ZacharyCarey/Dot-Matrix-Printer-Web-Interface/hardware/Board design 2025-09-17.png

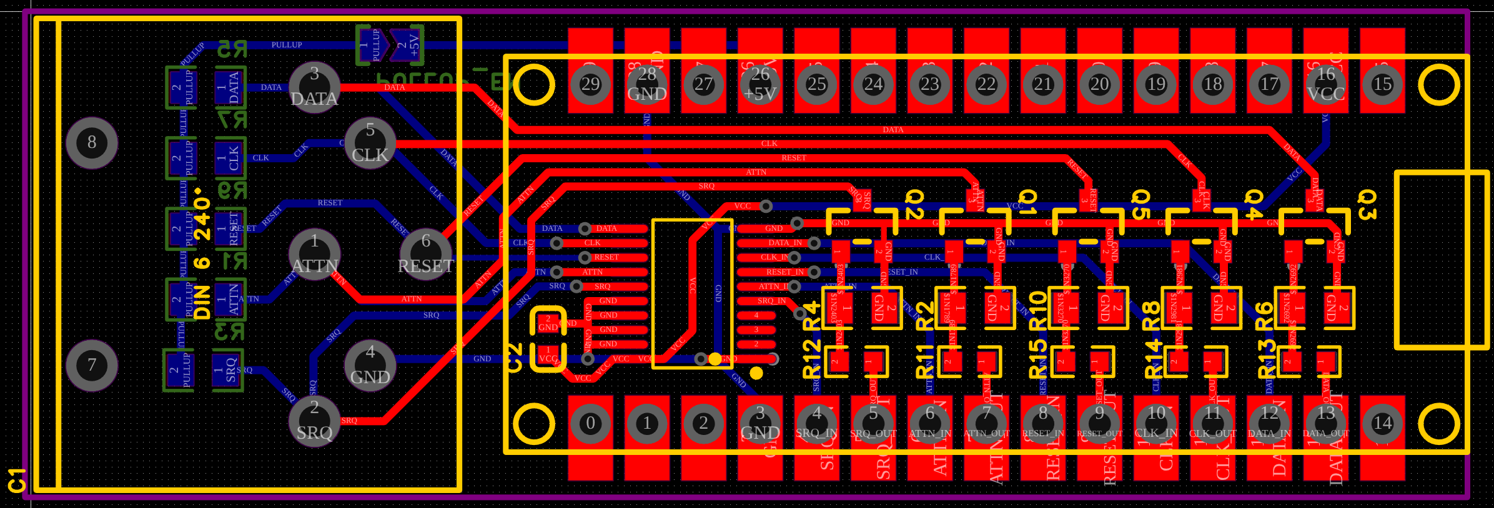
hardware/Board design 2025-09-17.png
