ZacharyCarey/Dot-Matrix-Printer-Web-Interface/hardware/Schematic design 2025-09-17.png

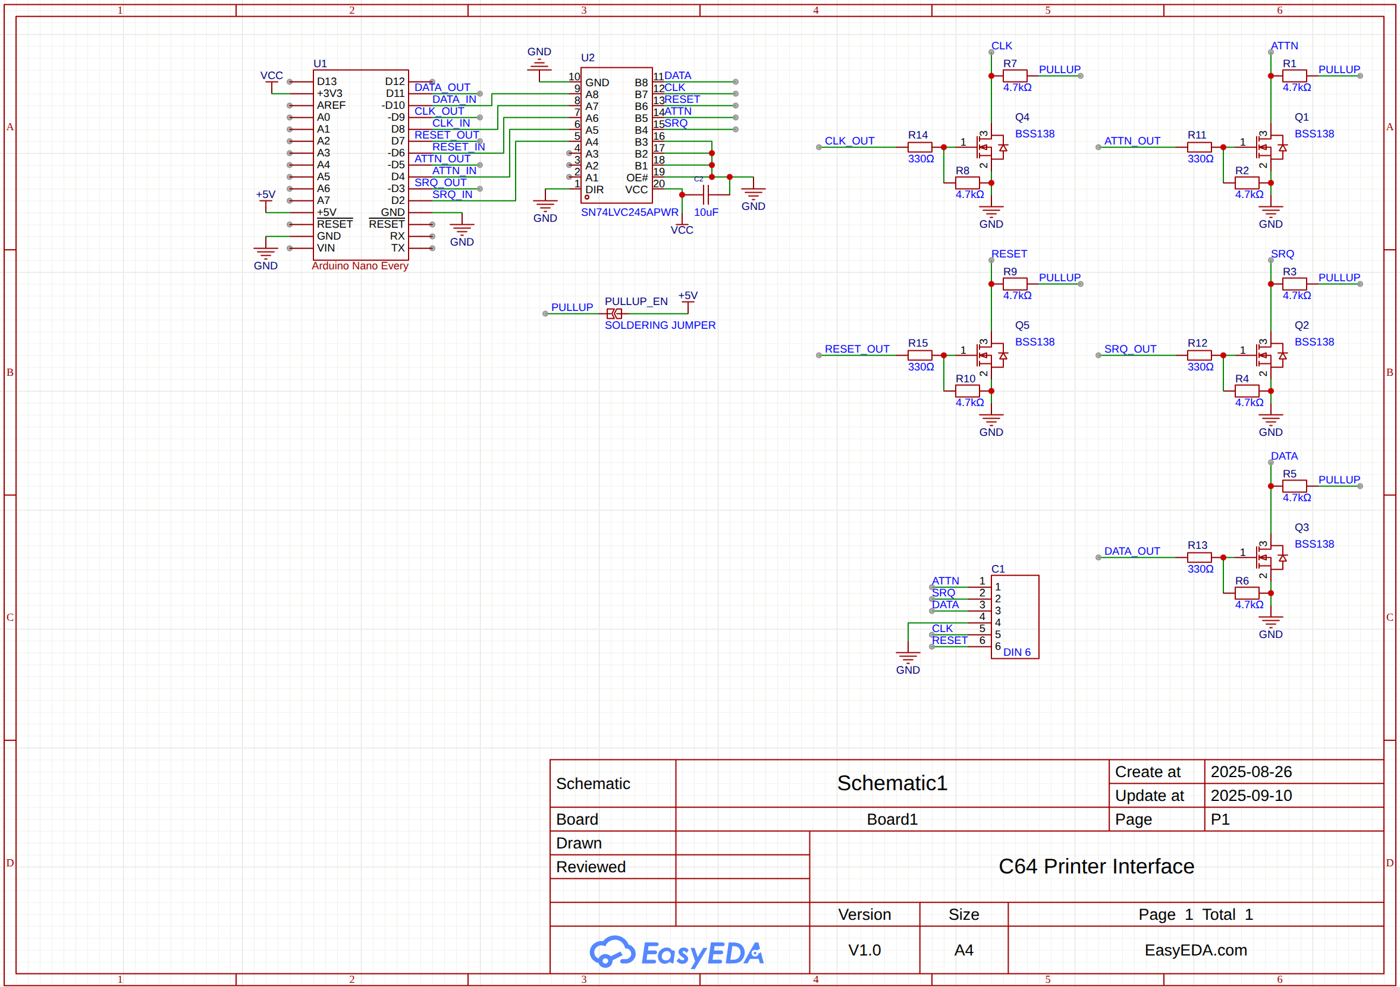
hardware/Schematic design 2025-09-17.png
