ZacharyCarey/Dot-Matrix-Printer-Web-Interface/hardware/BOM_Board1_PCB1_2025-08-30.csv

No. | Quantity | Comment | Designator | Footprint | Manufacturer PN | Digikey PN | JLCPCB PN
1 | 1 | DIN 6 Connector | C1 | FC680806 | FC680806 | 4654-FC680806-ND
2 | 5 | MOSFET | Q | SOT-23-3 | BSS138 | BSS138CT-ND | C2938375
3 | 10 | 4.7kΩ |  | 0805 | R1-R10 |  | C336873
4 | 1 | 10uF |  | 0603 | C2 |  | C96446
5 | 5 | 330Ω |  | 0603 | R11-R15 |  | C23138
6 | 1 | Voltage shifter | SN74LVC245A | TSSOP-20 | SN74LVC245APWR |  | C7848
7 | 1 | Arduino Nano ESP32 | U1 | Arduino Nano
