ZacharyCarey/Dot-Matrix-Printer-Web-Interface/hardware/JLCPCB_BOM.csv

No. | Quantity | Comment | Designator | Footprint | Value | Manufacturer Part | Manufacturer | Supplier Part | Supplier
1 | 1 | DIN 6 | C1 | FC680806
2 | 1 | 10uF | C2 | C0603 | 10uF | CL10A106MA8NRNC | SAMSUNG(三星) | C96446 | LCSC
3 | 1 | SOLDERING JUMPER | PULLUP_EN | JUMPER |  | SOLDERING JUMPER
4 | 5 | BSS138 | Q1,Q2,Q3,Q4,Q5 | SOT-23_L2.9-W1.3-P1.90-LS2.4-BR |  | BSS138 | GOODWORK(固得沃克) | C2938375 | LCSC
5 | 10 | 4.7kΩ | R1,R2,R3,R4,R5,R6,R7,R8,R9,R10 | R0805 | 4.7kΩ | ERJ6RBD4701V | PANASONIC(松下) | C336873 | LCSC
6 | 5 | 330Ω | R11,R12,R13,R14,R15 | R0603 | 330Ω | 0603WAF3300T5E | UNI-ROYAL(厚声) | C23138 | LCSC
7 | 1 | Arduino Nano Every | U1 | Arduino Nano Every (SMD)
8 | 1 | SN74LVC245APWR | U2 | TSSOP-20_L6.5-W4.4-P0.65-LS6.4-BL |  | SN74LVC245APWR | TI(德州仪器) | C7848 | LCSC
