ZacharyCarey/Dot-Matrix-Printer-Web-Interface/(list of files, drawings)

Other design files:
hardware/ProPrj_C64 Printer Interface_2025-09-17.epro
