ZacharyCarey/Dot-Matrix-Printer-Web-Interface/Dot-Matrix-Printer-Web-Interface/okidata120.cpp

#include "okidata120.h"

// TODO 178 = squared, 179 = cubed

uint8_t CURSOR_UP_LOOKUP[256] = {
  0, // NUL
  0, // 1
  0, // 2
  0, // 3
  0, // 4
  0, // 5
  0, // 6
  0, // 7
  0, // Backspace 8
  0, // Horizontal tab 9
  13, // Line feed \n 10
  0, // 11
  0, // Form feed 12
  0, // Carriage return \r 13
  0, // 14
  0, // 15
  0, // 16
  0, // 17
  0, // 18
  0, // 19
  0, // 20
  0, // 21
  0, // 22
  0, // 23
  0, // 24
  0, // 25
  0, // 26
  0, // Escape
  0, // 28
  0, // 29
  0, // 30
  0, // 31
  32, // Space
  33, // ! 33
  34, // " 34
  35, // # 35
  36, // $ 36
  37, // % 37
  38, // & 38
  39, // ' 39
  40, // ( 40
  41, // ) 41
  42, // * 42
  43, // + 43
  44, // , 44
  45, // - 45
  46, // . 46
  47, // / 47
  48, // 0 48
  49, // 1 49
  50, // 2 50
  51, // 3 51
  52, // 4 52
  53, // 5 53
  54, // 6 54
  55, // 7 55
  56, // 8 56
  57, // 9 57
  58, // : 58
  59, // ; 59
  60, // < 60
  61, // = 61
  62, // > 62
  63, // ? 63
  64, // @ 64
  65, // A 65
  66, // B 66
  67, // C 67
  68, // D 68
  69, // E 69
  70, // F 70
  71, // G 71
  72, // H 72
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
  0, // DEL 127
  92, // Euro => British pound 128
  0, // 129
  0, // 130
  0, // 131
  0, // 132
  0, // 133
  0, // 134
  0, // 135
  0, // 136
  0, // 137
  0, // 138
  0, // 139
  0, // 140
  0, // 141
  0, // 142
  0, // 143
  0, // 144
  39, // left single quote => ' 145
  39, // right single quote => ' 146
  34, // left double quote => " 147
  34, // right double quote => " 148
  113, // Bullet 149
  45, // en dash 150
  45, // em dash 151
  0, // 152
  0, // 153
  0, // 154
  0, // 155
  0, // 156
  0, // 157
  0, // 158
  0, // 159
  0, // 160
  0, // 161
  0, // 162
  92, // British pound 163
  0, // 164
  0, // 165
  0, // 166
  0, // 167
  0, // 168
  0, // 169
  0, // 170
  0, // 171
  0, // 172
  0, // 173
  0, // 174
  0, // 175
  0, // 176
  0, // 177
  0, // 178
  0, // 179
  0, // 180
  0, // 181
  0, // 182
  0, // 183
  0, // 184
  0, // 185
  0, // 186
  0, // 187
  0, // 188
  0, // 189
  0, // 190
  0, // 191
  0, // 192
  0, // 193
  0, // 194
  0, // 195
  0, // 196
  0, // 197
  0, // 198
  0, // 199
  0, // 200
  0, // 201
  0, // 202
  0, // 203
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
};

uint8_t CURSOR_DOWN_LOOKUP[256] = {
  0, // NUL
  0, // 1
  0, // 2
  0, // 3
  0, // 4
  0, // 5
  0, // 6
  0, // 7
  0, // Backspace 8
  0, // Horizontal tab 9
  13, // Line feed \n 10
  0, // 11
  0, // Form feed 12
  0, // Carriage return \r 13
  0, // 14
  0, // 15
  0, // 16
  0, // 17
  0, // 18
  0, // 19
  0, // 20
  0, // 21
  0, // 22
  0, // 23
  0, // 24
  0, // 25
  0, // 26
  0, // Escape
  0, // 28
  0, // 29
  0, // 30
  0, // 31
  32, // Space
  33, // ! 33
  34, // " 34
  35, // # 35
  36, // $ 36
  37, // % 37
  38, // & 38
  39, // ' 39
  40, // ( 40
  41, // ) 41
  42, // * 42
  43, // + 43
  44, // , 44
  45, // - 45
  46, // . 46
  47, // / 47
  48, // 0 48
  49, // 1 49
  50, // 2 50
  51, // 3 51
  52, // 4 52
  53, // 5 53
  54, // 6 54
  55, // 7 55
  56, // 8 56
  57, // 9 57
  58, // : 58
  59, // ; 59
  60, // < 60
  61, // = 61
  62, // > 62
  63, // ? 63
  64, // @ 64
  97, // A 65
  98, // B 66
  99, // C 67
  100, // D 68
  101, // E 69
  102, // F 70
  103, // G 71
  104, // H 72
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
  0, // DEL 127
  92, // Euro => British pound 128
  0, // 129
  0, // 130
  0, // 131
  0, // 132
  0, // 133
  0, // 134
  0, // 135
  0, // 136
  0, // 137
  0, // 138
  0, // 139
  0, // 140
  0, // 141
  0, // 142
  0, // 143
  0, // 144
  39, // left single quote => ' 145
  39, // right single quote => ' 146
  34, // left double quote => " 147
  34, // right double quote => " 148
  0, // Bullet 149
  45, // en dash 150
  45, // em dash 151
  0, // 152
  0, // 153
  0, // 154
  0, // 155
  0, // 156
  0, // 157
  0, // 158
  0, // 159
  0, // 160
  0, // 161
  0, // 162
  92, // British pound 163
  0, // 164
  0, // 165
  0, // 166
  0, // 167
  0, // 168
  0, // 169
  0, // 170
  0, // 171
  0, // 172
  0, // 173
  0, // 174
  0, // 175
  0, // 176
  0, // 177
  0, // 178
  0, // 179
  0, // 180
  0, // 181
  0, // 182
  0, // 183
  0, // 184
  0, // 185
  0, // 186
  0, // 187
  0, // 188
  0, // 189
  0, // 190
  0, // 191
  0, // 192
  0, // 193
  0, // 194
  0, // 195
  0, // 196
  0, // 197
  0, // 198
  0, // 199
  0, // 200
  0, // 201
  0, // 202
  0, // 203
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
};

size_t okidata_translate(uint8_t* data, size_t length, uint8_t* out_buffer, size_t out_buffer_len)
{
  if (length == 0 || out_buffer_len < 2) return 0;

  bool cursorDown = false;
  uint8_t* start = out_buffer;

  // Send reset char to reset cursor mode (to keep a know state for our simplicity)
  *(out_buffer++) = CMD_CANCEL;
  out_buffer_len--;

  for (size_t i = 0; i < length; i++)
  {
    uint8_t c;
    if (cursorDown)
      c = CURSOR_DOWN_LOOKUP[data[i]];
    else
      c = CURSOR_UP_LOOKUP[data[i]];

    if (c == 0)
    {
      // Character was zero, meaning it was not found in the current charset
      // Try and find the character in the other charset
      if (cursorDown)
        c = CURSOR_UP_LOOKUP[data[i]];
      else
        c = CURSOR_DOWN_LOOKUP[data[i]];

      if (c == 0)
      {
        // Character doesn't exist at all, just print a space instead
        c = ' ';
      } else {
        // We need to switch charsets to print this char, ensure there's enough room for both characters
        if (out_buffer_len < 2) return (size_t)(out_buffer - start);
        *(out_buffer++) = (cursorDown ? CMD_CURSOR_UP : CMD_CURSOR_DOWN);
        out_buffer_len--;
        cursorDown = !cursorDown;
      }
    }

    // Save character to buffer, possibly after switching cursor mode
    *(out_buffer++) = c;
    out_buffer_len--;
    if (out_buffer_len == 0) return (size_t)(out_buffer - start);
  }

  return (size_t)(out_buffer - start);
}
