ZacharyCarey/Dot-Matrix-Printer-Web-Interface/Dot-Matrix-Printer-Web-Interface/wifi_password_example.h

// Copy and rename this file to "wifi_password.h"
// BE EXTRA CAREFUL NOT TO ACCIDENTLY UPLOAD YOUR WIFI PASSWORD TO GIT

#ifndef WIFI_PASSWORD_H
#define WIFI_PASSWORD_H

const char* wifi_ssid = "WIFI name here";
const char* wifi_password = "WIFI password here";

#endif
