ZacharyCarey/Dot-Matrix-Printer-Web-Interface/(commit log)

2025-08-27 Working prototype
2025-08-29 Imported required libraries
    [cmn_crt_authorities.csv]
2025-08-30 Attempt to fix printing issues
2025-08-30 Bug fixes and minor adjustments
    [Dot-Matrix-Printer-Web-Interface.ino]
2025-08-31 Movied arduino skets into it's own folder and cleaned up project
2025-08-31 Uploaded hardware schematics
    [BOM_Board1_PCB1_2025-08-30.csv, ProPrj_C64 Printer Interface_2025-08-30.epro]
2025-08-31 Prepare IEC driver for new hardware layout
2025-09-18 Verified working with new PCB
2025-09-18 Upaded PCB design and Readme
    [BOM_Board1_PCB1_2025-08-30.csv, JLCPCB_BOM.csv, ProPrj_C64 Printer Interface_2025-08-30.epro, ProPrj_C64 Printer Interface_2025-09-17.epro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]
2025-09-18 More robust IEC driver
2025-09-23 Used logic analyzer to find bus bugs
    [Dot-Matrix-Printer-Web-Interface.ino]
2025-10-07 Basic UART interface working with printer
2025-10-31 Fixed non-ascii characters being sent to printer, causing erroneous characters to print
    [Dot-Matrix-Printer-Web-Interface.ino, iec_interface.h, okidata120.cpp, okidata120.h]
